robbyn/partybooth/partybooth/doc/bom.ods

Qty | Ref. | Value | Description | Supplier | SKU | Unit price | Price
1 | PCB | Partybooth V1 | Printed Circuit Board |  |  | 5 | 5
1 | C1 | 0.1uF | Ceramic Disk Capacitor 0.1uF/50V |  |  | 0.3 | 0.3
1 | C2 | 100uF | Radial Electrolytic 100uF/25V |  |  | 0.5 | 0.5
1 | C3 | 10uF | Radial Electrolytic 10uF/16V |  |  | 0.5 | 0.5
1 | D1 | 1N4007 | Diode |  |  | 0.25 | 0.25
1 | IC1 | ATtiny13 | Atmel ATtiny13 microcontroller |  |  | 2 | 2
1 | IC2 | 78L05Z | Voltage Regulator, TO-92 |  |  | 1 | 1
2 | J1,J2 | 2x1 pin | 0.1” Two pin connector |  |  | 0.5 | 1
1 | J3 | 2.1mm | DC Barrel Power Jack, 2.1mm | Sparkfun | PRT-00119 |  | 0
1 | OK1 | ISD5X | ISOCOM ISD5X – Dual Optoisolator | Farnell | 1683211 | 0.5 | 0.5
2 | R1,R2 | 430Ω | Carbon Film Resistors ¼W 5% |  |  | 0.3 | 0.6
2 | R3,R4 | 10kΩ | Carbon Film Resistors ¼W 5% |  |  | 0.3 | 0.6
2 | R5,R6 | 220Ω | Carbon Film Resistors ¼W 5% |  |  | 0.3 | 0.6
1 | SG1 | 2kHz | 2kHz buzzer | Sparkfun | COM-07950 | 1.95 | 1.95
1 | SV1 | ICSP | 6 pin (2x3) ICSP connector |  |  | 0.5 | 0.5
2 | T1,T2 | 2N3904 | Fairchild 2N390TF, TO-92 | Farnell | 1704727 | 0.3 | 0.6
1 | X1 | 1501 06 | Lumberg 2.5mm stereo jack 1501 06 | Farnell | 1308867 | 2.2 | 2.2
 |  |  |  |  |  |  | 0
1 |  | BTN | Sparkfun Big Dome Push button | Sparkfun | COM-09181 | 9.95 | 9.95
1 |  | Wire | Ribbon Cable - 6 wire | Sparkfun | CAB-10648 | 0.75 | 0.75
2 |  |  | Polarized Connectors - Housing (2-Pin) | Sparkfun | PRT-08095 | 0.45 | 0.9
1 |  |  | Polarized Connectors - Crimp Pins | Sparkfun | PRT-08100 | 1.95 | 1.95
1 |  | 12V | 12V DC power supply unit | Farnell | 1279515 | 15 | 15
 |  |  |  |  |  |  | 0
1 |  |  | Vello Camera remote shutter cable | B&H | VERCCN1 or VERCCC1 | 7.5 | 7.5
 |  |  |  |  |  |  | 54.15
