robbyn/partybooth/partybooth/eagle/partybooth.brd

## EAGLE design partybooth/eagle/partybooth.brd (2012-04-22)

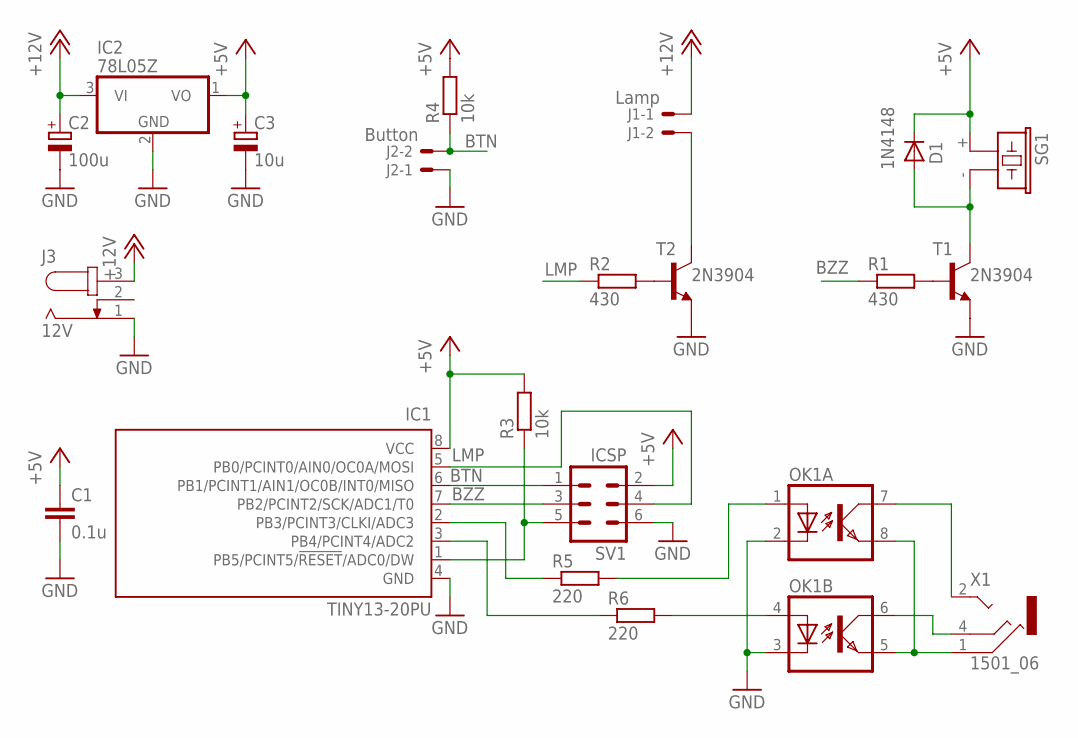
[picture p1: schematic partybooth.sch]

Parts:
C1: 0.1u; C050-025X075
C2: 100u; E5-6
C3: 10u; E5-5
D1: 1N4148; DO35-7
IC1: TINY13-20PU; DIL08
IC2: 78L05Z; TO92
J1: Lamp; 6410-02
J2: Button; 6410-02
J3: 12V; SPC4077
OK1: ILD2; DIL08
R1, R2: 430; 0204/7
R3, R4: 10k; 0204/7
R5, R6: 220; 0204/7
SG1: F/CM12P
SV1: ICSP; MA03-2
T1, T2: 2N3904; TO92
X1: 1501_06

Connections:
+5V: C1.1, C3.+, D1.C, IC1.8 (VCC), IC2.1 (VO), R3.2, R4.2, SG1.+ (1), SV1.2
+12V: C2.+, IC2.3 (VI), J1.1, J3.3
BTN: IC1.6 (PB1/PCINT1/AIN1/OC0B/INT0/MISO), J2.2, R4.1, SV1.1
BZZ: IC1.7 (PB2/PCINT2/SCK/ADC1/T0), R1.1, SV1.3
FOC: OK1.4 (A), R6.2
GND: C1.2, C2.-, C3.-, IC1.4 (GND), IC2.2 (GND), J2.1, J3.1, OK1.2 (C), OK1.3 (C), SV1.6, T1.3 (E), T2.3 (E)
LMP: IC1.5 (PB0/PCINT0/AIN0/OC0A/MOSI), R2.1, SV1.4
unnamed: R1.2, T1.2 (B)
unnamed: D1.A, SG1.- (2), T1.1 (C)
unnamed: R2.2, T2.2 (B)
unnamed: J1.2, T2.1 (C)
unnamed: OK1.1 (A), R5.2
unnamed: IC1.1 (PB5/PCINT5/!RESET!/ADC0/DW), R3.1, SV1.5
unnamed: IC1.3 (PB4/PCINT4/ADC2), R6.1
unnamed: OK1.5 (EMIT), OK1.8 (EMIT), X1.1
unnamed: OK1.6 (COL), X1.4 (3)
unnamed: OK1.7 (COL), X1.2
SHT: IC1.2 (PB3/PCINT3/CLKI/ADC3), R5.1

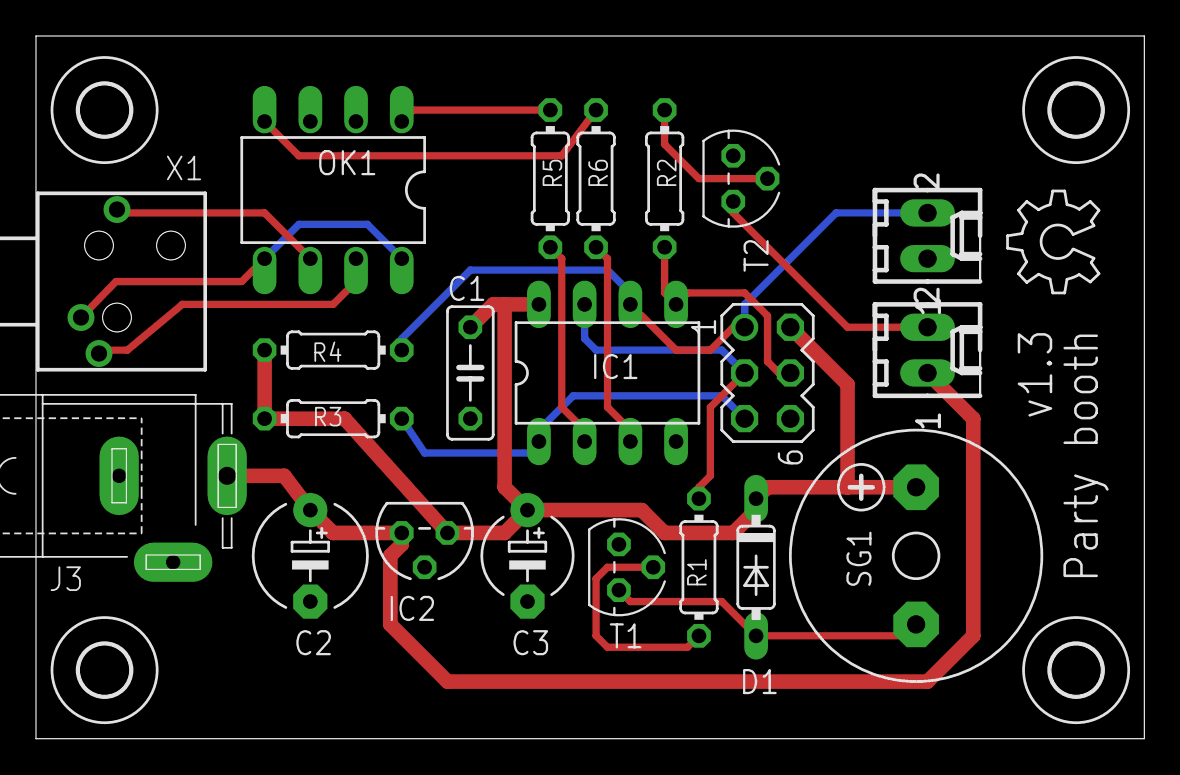
[picture p2: board partybooth.brd from above]

Board: 2 copper layers, 61.6 x 39.0 mm, 26 parts (0 on the bottom side), 18 nets.

Other parts of the board:
U$1: OSHW_6X200_NOTEXT
U$2, U$3, U$4, U$5: 2,8
